savob/drone_computer/hardware/renders/flight_controller_v2_front.png

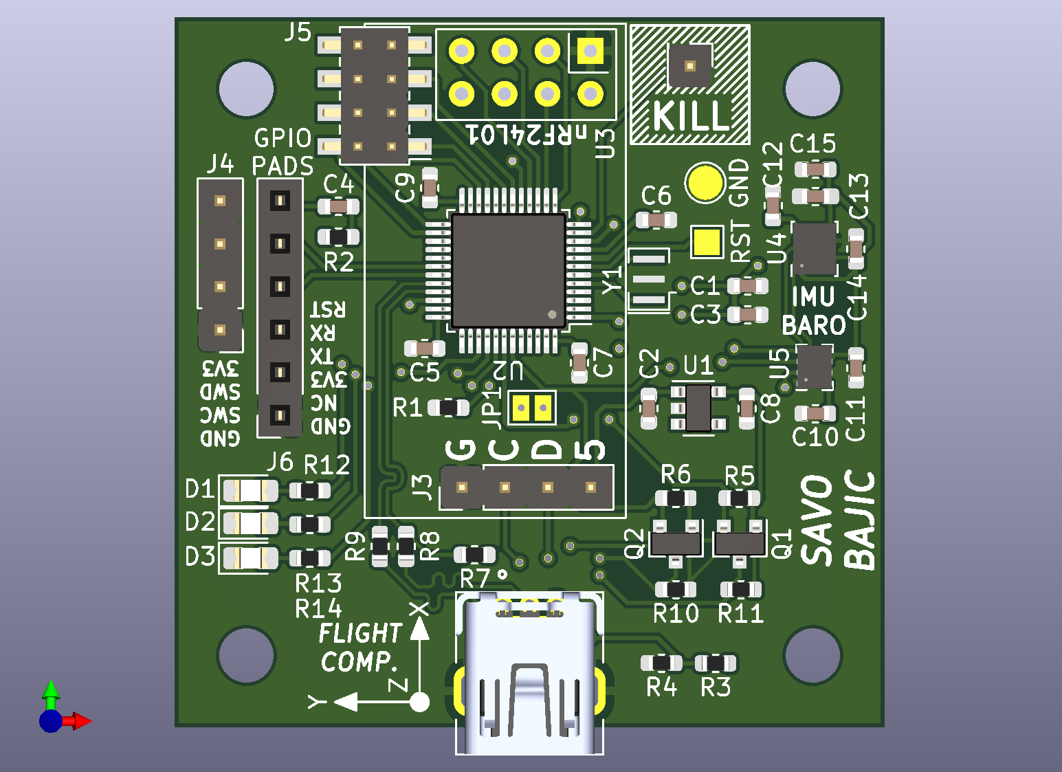
hardware/renders/flight_controller_v2_front.png
