savob/drone_computer/hardware/renders/flight_controller_v2_back.png

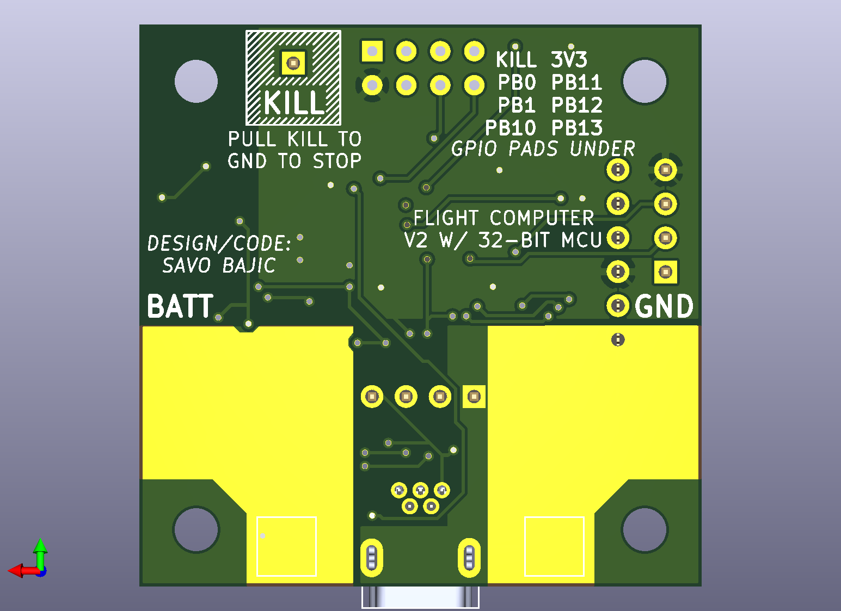
hardware/renders/flight_controller_v2_back.png
