savob/drone_computer/readme.md

# Flight Computer Project

This is the code and hardware design files for my custom flight computer board and its components.

It's been on a haitus for a while, I hope to pick it up again sometime though.
