savob/drone_computer/hardware/README.md

# Flight Computer Hardware Files

Here are the files related to the hardware design. They are all from KiCad 7.0.10 at the oldest.

## Projects

| Project | Description |
| --- | --- |
| `drone_regulator` | An noise rejecting voltage regulator board |
| `flight_computer_vX` | Different versions of the flight computer |

## Other Files and Folders

| Folder | Purpose |
| --- | --- |
| `renders` | Front and back 3D renders of the boards |
| `schematics` | Has the schematics in PDF (colour and B/W) and SVG (just colour) formats |
| `small_title_block.kicad_wks` | has the worksheet template with a more compact titleblock |
