savob/drone_computer/firmware/computer_v2/readme.md

# Flight Computer Code

This is the code for my custom flight computer board and its components.
