savob/drone_computer/hardware/renders/flight_controller_back.png

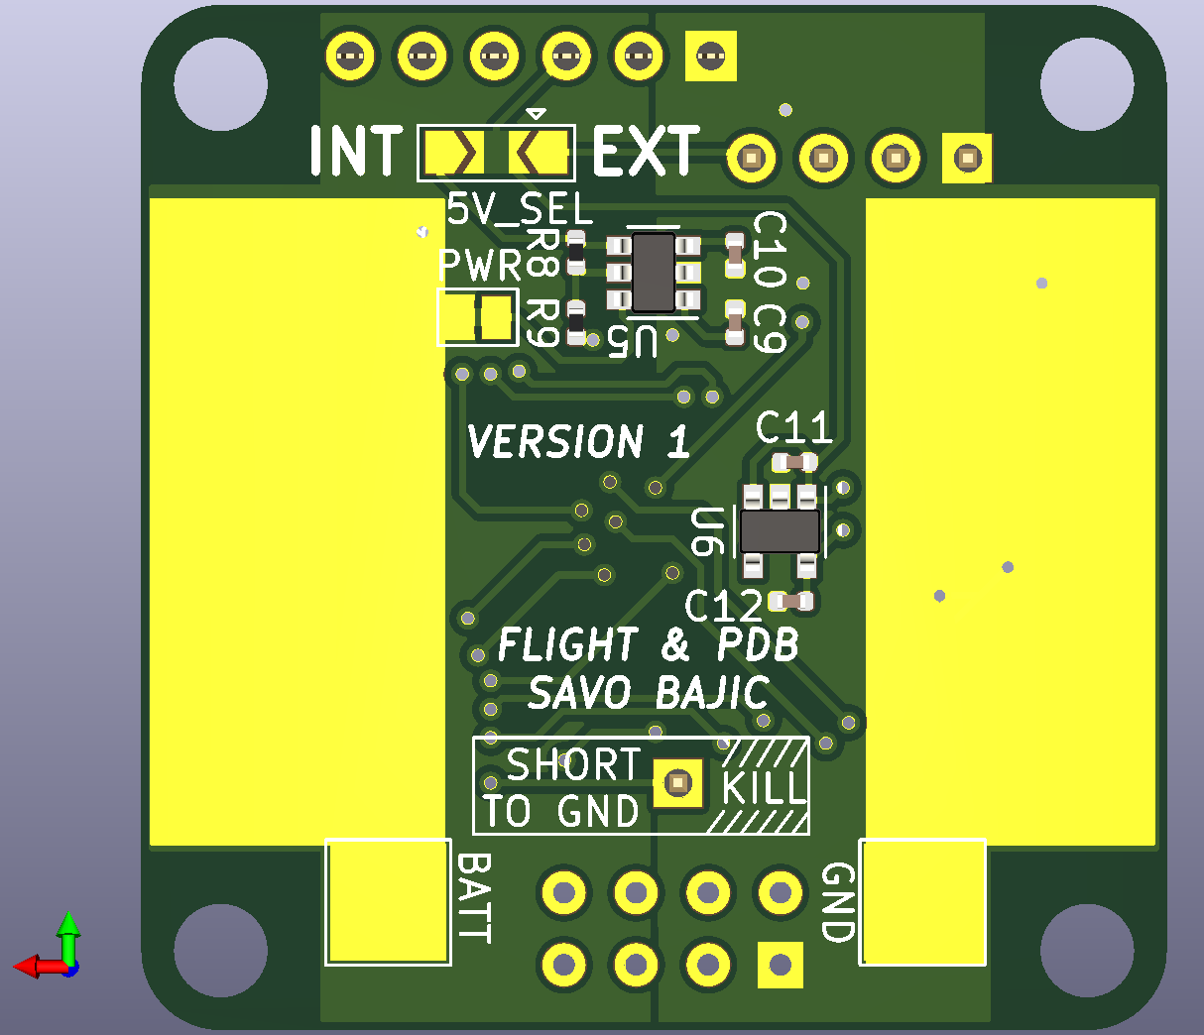
hardware/renders/flight_controller_back.png
