savob/drone_computer/hardware/renders/flight_controller_front.png

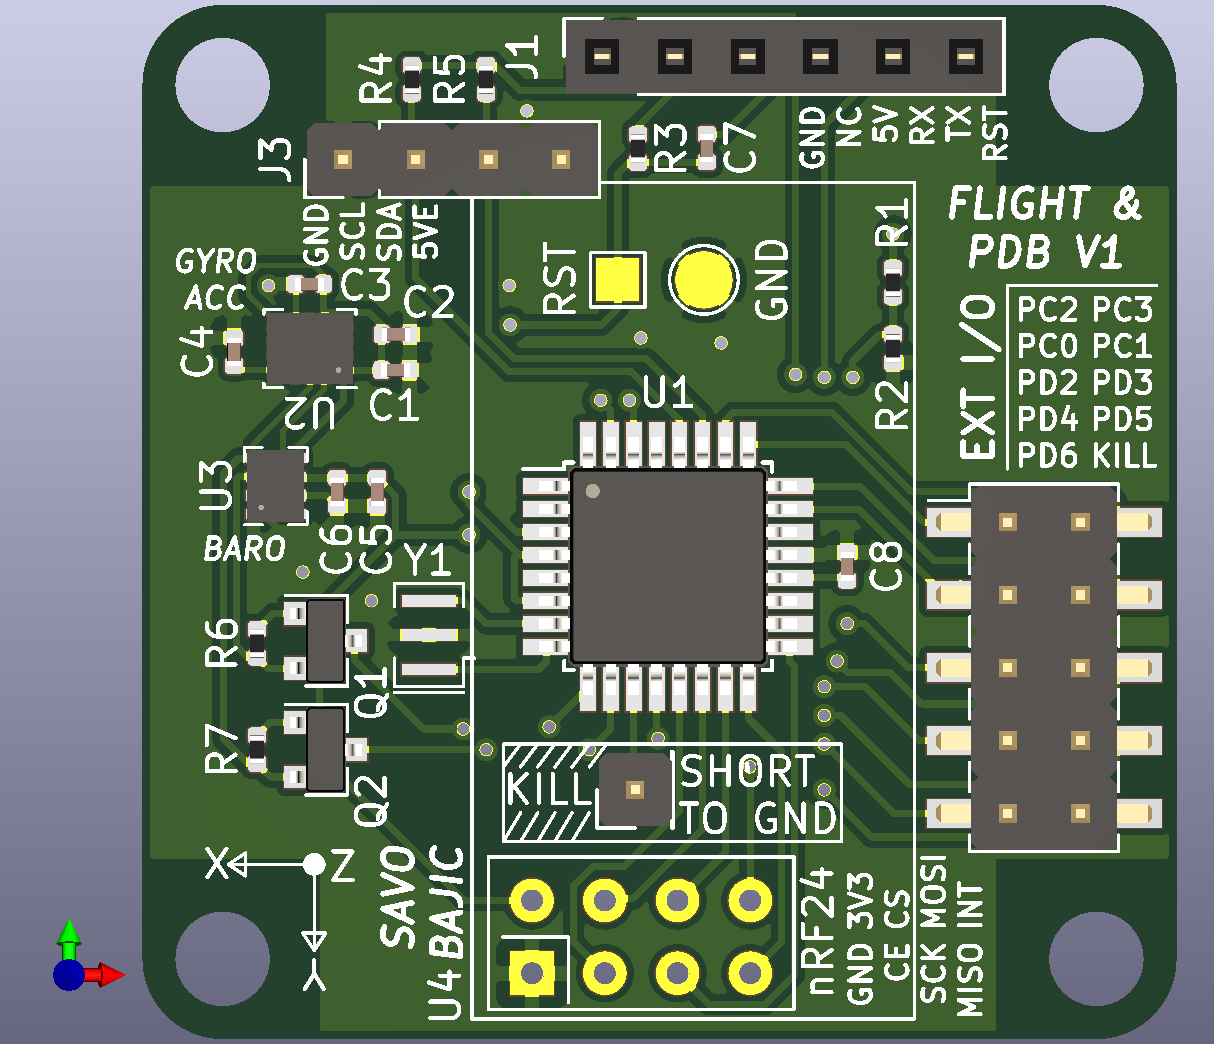
hardware/renders/flight_controller_front.png
