savob/drone_computer/hardware/flight_controller_v2/2172034-1/2172034-1--3DModel-STEP-56544.STEP

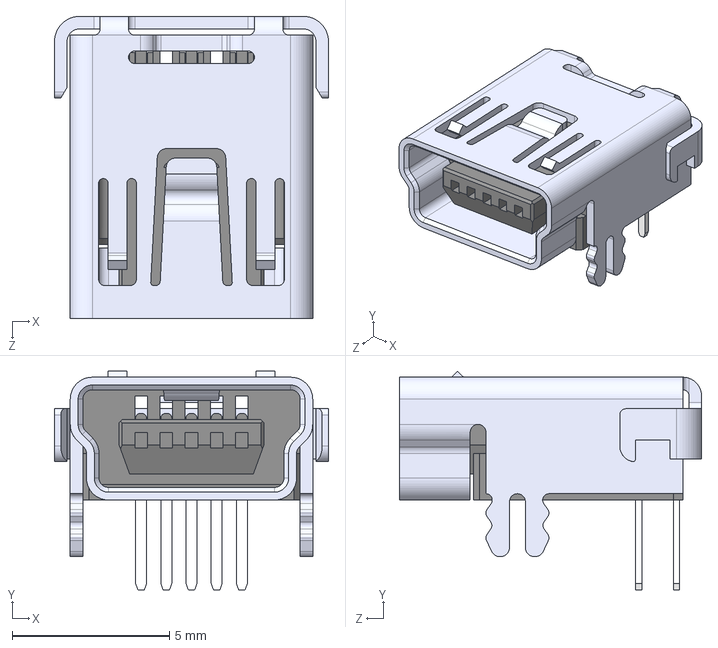
[picture p5: CAD file, 2024-01-08]
hardware/flight_controller_v2/2172034-1/2172034-1--3DModel-STEP-56544.STEP
8.70 x 6.94 x 9.60 mm
