savob/drone_computer/hardware/drone_regulator/drone_regulator.pdf

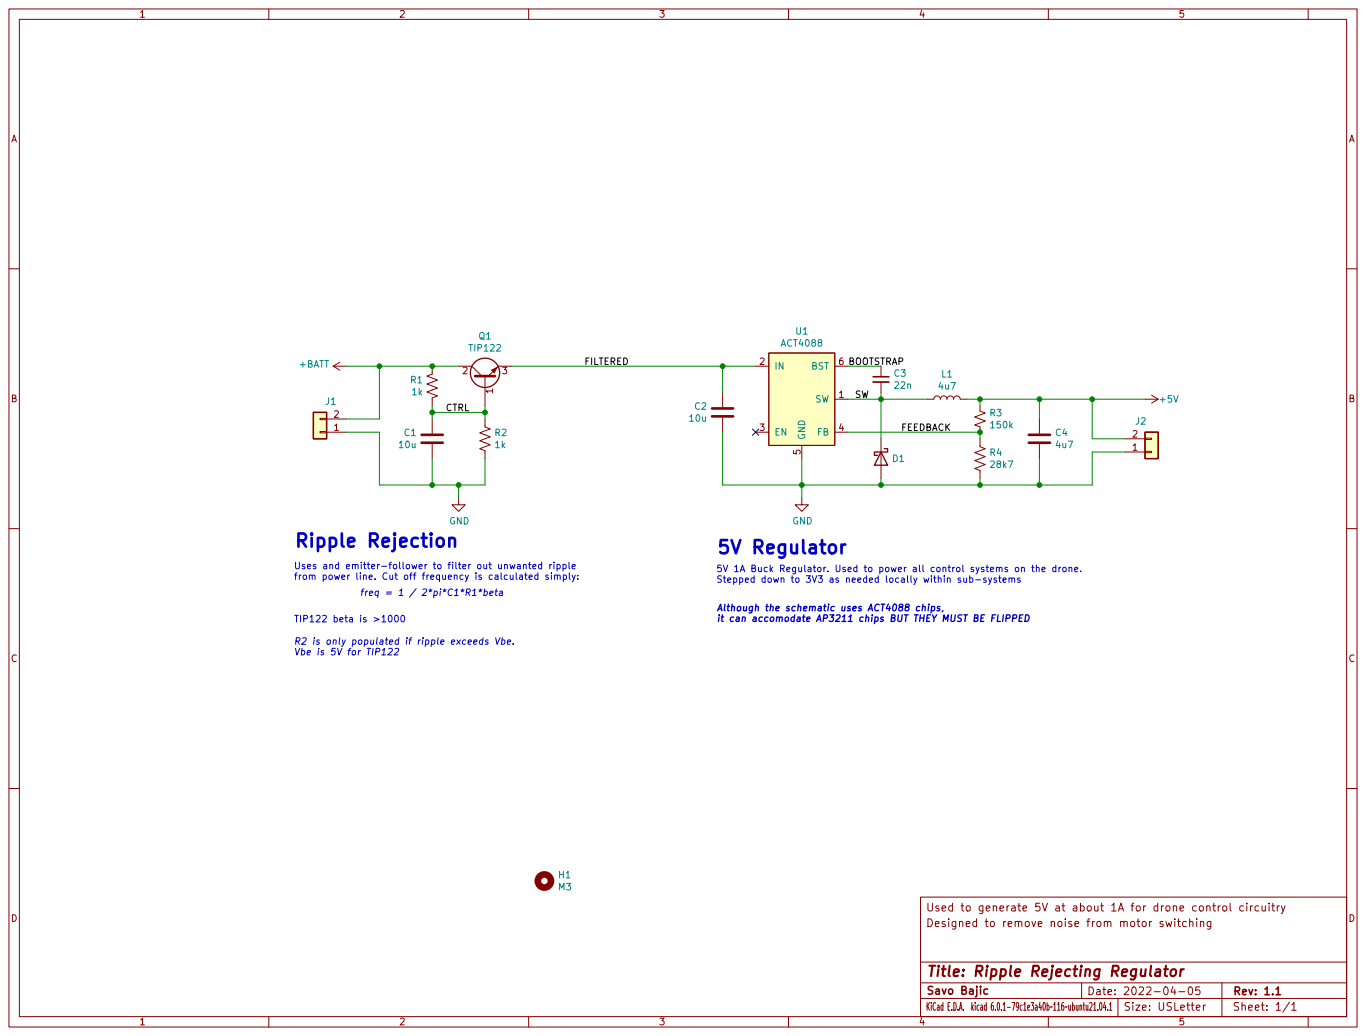
[picture p6: page 1]

Used to generate 5V at about 1A for drone control circuitry KiCad E.D.A. kicad 6.0.1-79c1e3a40b~116~ubuntu21.04.1 R3

Uses and emitter-follower to filter out unwanted ripple
from power line. Cut off frequency is calculated simply: TIP122 beta is >1000

5V 1A Buck Regulator. Used to power all control systems on the drone.
Stepped down to 3V3 as needed locally within sub-systems

it can accomodate AP3211 chips BUT THEY MUST BE FLIPPED

Designed to remove noise from motor switching
