savob/drone_computer/hardware/schematics/flight_controller_v2.pdf

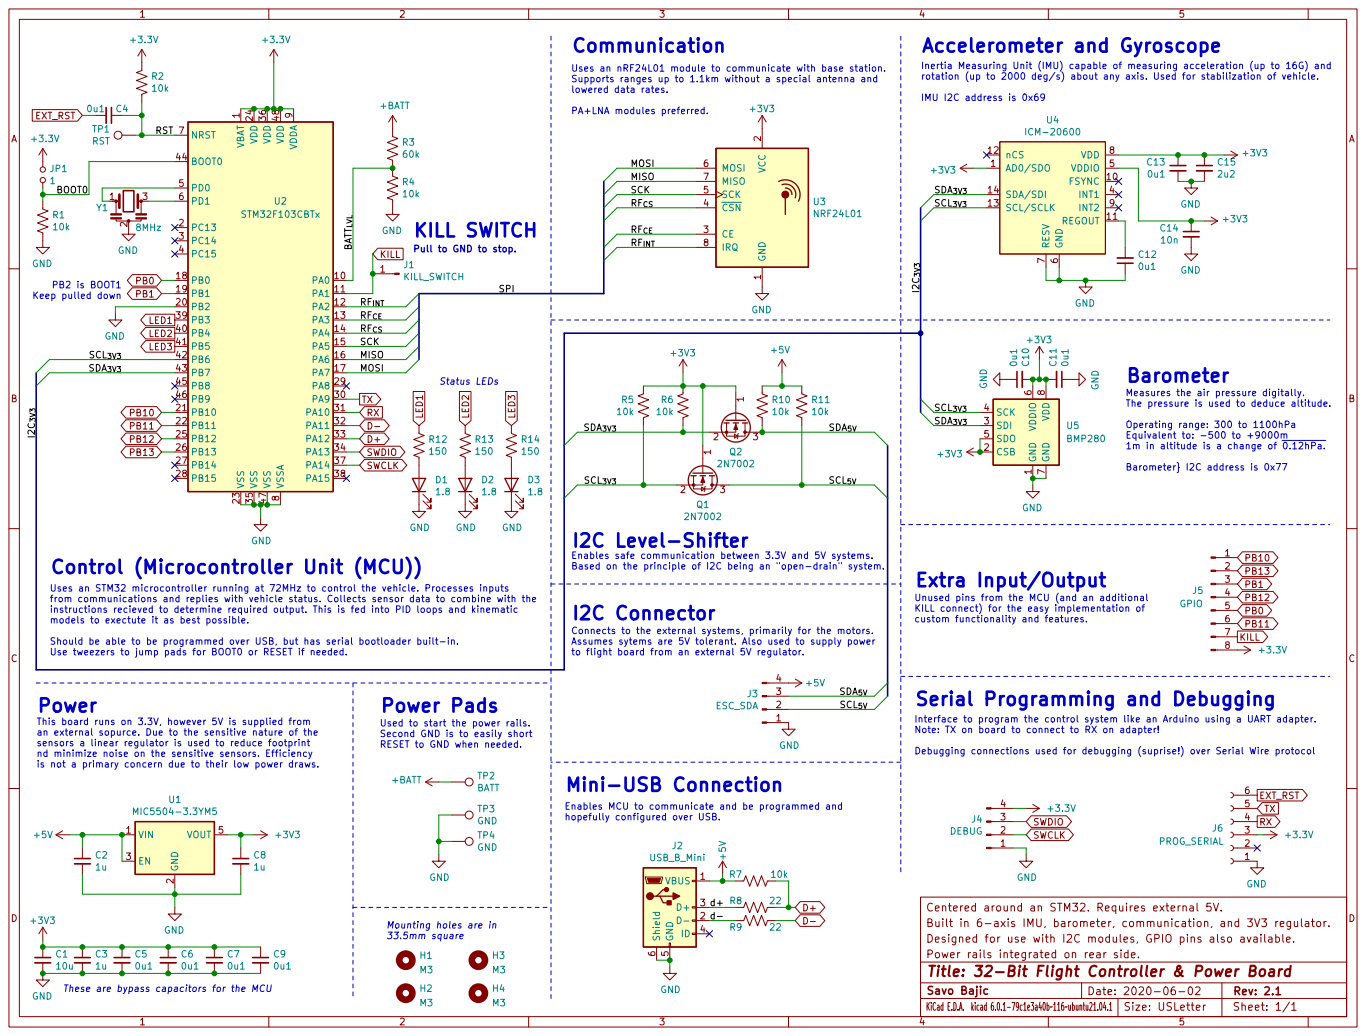
[picture p8: page 1]
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

IMU I2C address is 0x69 Used to start the power rails.

lowered data rates. PA+LNA modules preferred.

1 PA0 10 PA1 11 PA2 12 PA3 13 PA4 14 PA5 15 PA6 16 PA7 17 PB0 18 PB1 19 PC13 2 PB2 20 PB10 21 PB11 22 VSS 23 VDD 24 PB12 25 PB13 26 PB14 27 PB15 28 PA8 29 PC14 3 PA9 30 PA10 31 PA11 32 PA12 33 PA13 34 VSS 35 VDD 36 PA14 37 PA15 38 PB3 39 PC15 4 PB4 40 PB5 41 PB6 42 PB7 43 BOOT0 44 PB8 45 PB9 46 VSS 47 VDD 48 PD0 5 PD1 6 NRST 7 VSSA

2 CE 3 ~{CSN} 4 SCK 5 MOSI 6 MISO 7
RF_{INT} MISO

Status LEDs Pull to GND to stop.
J1KILL_SWITCH

PB2 is BOOT1 Keep pulled down

Measures the air pressure digitally.
The pressure is used to deduce altitude.

1 CSB 2 SDI 3 SCK 4 SDO 5 VDDIO

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

Control (Microcontroller Unit (MCU))

Second GND is to easily short RESET to GND when needed. Uses an STM32 microcontroller running at 72MHz to control the vehicle. Processes inputs
from communications and replies with vehicle status. Collects sensor data to combine with the
instructions recieved to determine required output. This is fed into PID loops and kinematic
models to exectute it as best possible.

Unused pins from the MCU (and an additional
KILL connect) for the easy implementation of
custom functionality and features.

Should be able to be programmed over USB, but has serial bootloader built-in.
Use tweezers to jump pads for BOOT0 or RESET if needed.

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

Serial Programming and Debugging

This board runs on 3.3V, however 5V is supplied from
an external sopurce. Due to the sensitive nature of the
sensors a linear regulator is used to reduce footprint
nd minimize noise on the sensitive sensors. Efficiency
is not a primary concern due to their low power draws.

Interface to program the control system like an Arduino using a UART adapter.
Note: TX on board to connect to RX on adapter!

Debugging connections used for debugging (suprise!) over Serial Wire protocol

Enables MCU to communicate and be programmed and
hopefully configured over USB.

Centered around an STM32. Requires external 5V. KiCad E.D.A. kicad 6.0.1-79c1e3a40b~116~ubuntu21.04.1 C2

Built in 6-axis IMU, barometer, communication, and 3V3 regulator.
Designed for use with I2C modules, GPIO pins also available.
Power rails integrated on rear side.

Mounting holes are in
33.5mm square

These are bypass capacitors for the MCU
