savob/drone_computer/hardware/drone_regulator/drone_regulator.kicad_pcb

## KiCad design hardware/drone_regulator/drone_regulator.kicad_pcb (2024-01-08)

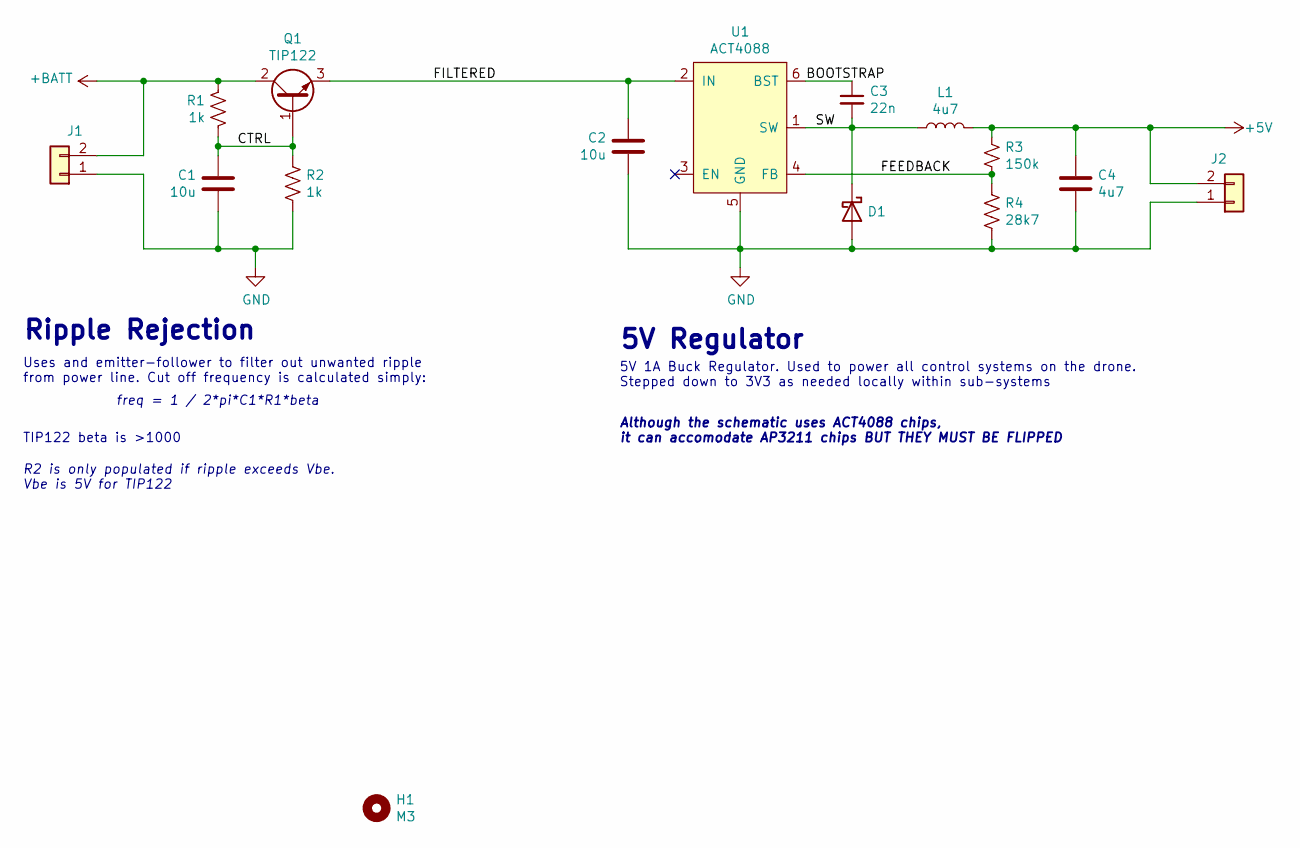
[picture p9: schematic drone_regulator.kicad_sch, Ripple Rejecting Regulator]

Parts:
C1: 10u; C_Radial_D6.3mm_H7.0mm_P2.50mm
C2: 10u; C_0805_2012Metric
C3: 22n; C_0402_1005Metric
C4: 4u7; C_0805_2012Metric
D1: 0v7; D_SOD-323
H1: M3; MountingHole_3.2mm_M3
J1, J2: Conn_01x02; PinHeader_1x02_P2.54mm_Vertical
L1: 4u7; L_Taiyo-Yuden_NR-30xx
Q1: TIP122; TO-220-3_Vertical
R1, R2: 1k; R_Axial_DIN0207_L6.3mm_D2.5mm_P2.54mm_Vertical
R3: 150k; R_0402_1005Metric
R4: 28k7; R_0402_1005Metric
U1: ACT4088; SOT-23-6

Connections:
+5V: C4.1, J2.2, L1.2, R3.1
+BATT: J1.2, Q1.2 (C), R1.2
/BOOTSTRAP: C3.1, U1.6 (BST)
/CTRL: C1.2, Q1.1 (B), R1.1, R2.2
/FEEDBACK: R3.2, R4.1, U1.4 (FB)
/FILTERED: C2.2, Q1.3 (E), U1.2 (IN)
/SW: C3.2, D1.1 (K), L1.1, U1.1 (SW)
GND: C1.1, C2.1, C4.2, D1.2 (A), J1.1, J2.1, R2.1, R4.2, U1.5 (GND)

Notes on the sheet:
5V 1A Buck Regulator. Used to power all control systems on the drone. Stepped down to 3V3 as needed locally within sub-systems
R2 is only populated if ripple exceeds Vbe. Vbe is 5V for TIP122
Ripple Rejection
Although the schematic uses ACT4088 chips, it can accomodate AP3211 chips BUT THEY MUST BE FLIPPED
Uses and emitter-follower to filter out unwanted ripple from power line. Cut off frequency is calculated simply: TIP122 beta is >1000
5V Regulator
freq = 1 / 2*pi*C1*R1*beta

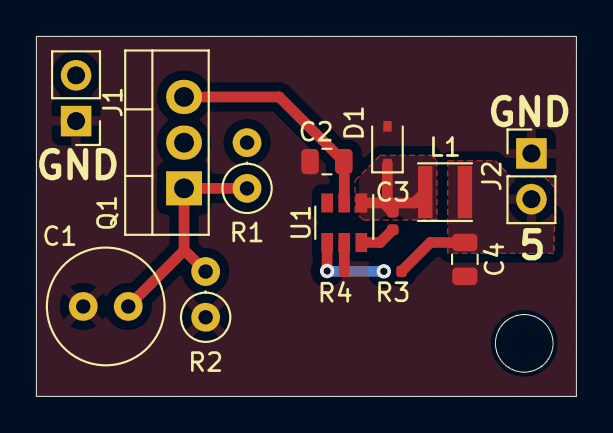
[picture p10: board drone_regulator.kicad_pcb from above]

Board: 2 copper layers, 30.0 x 20.0 mm, 15 parts (0 on the bottom side), 8 nets.
