savob/drone_computer/hardware/flight_controller_v2/flight_controller_v2.kicad_pcb

## KiCad design hardware/flight_controller_v2/flight_controller_v2.kicad_pcb (2024-01-08)

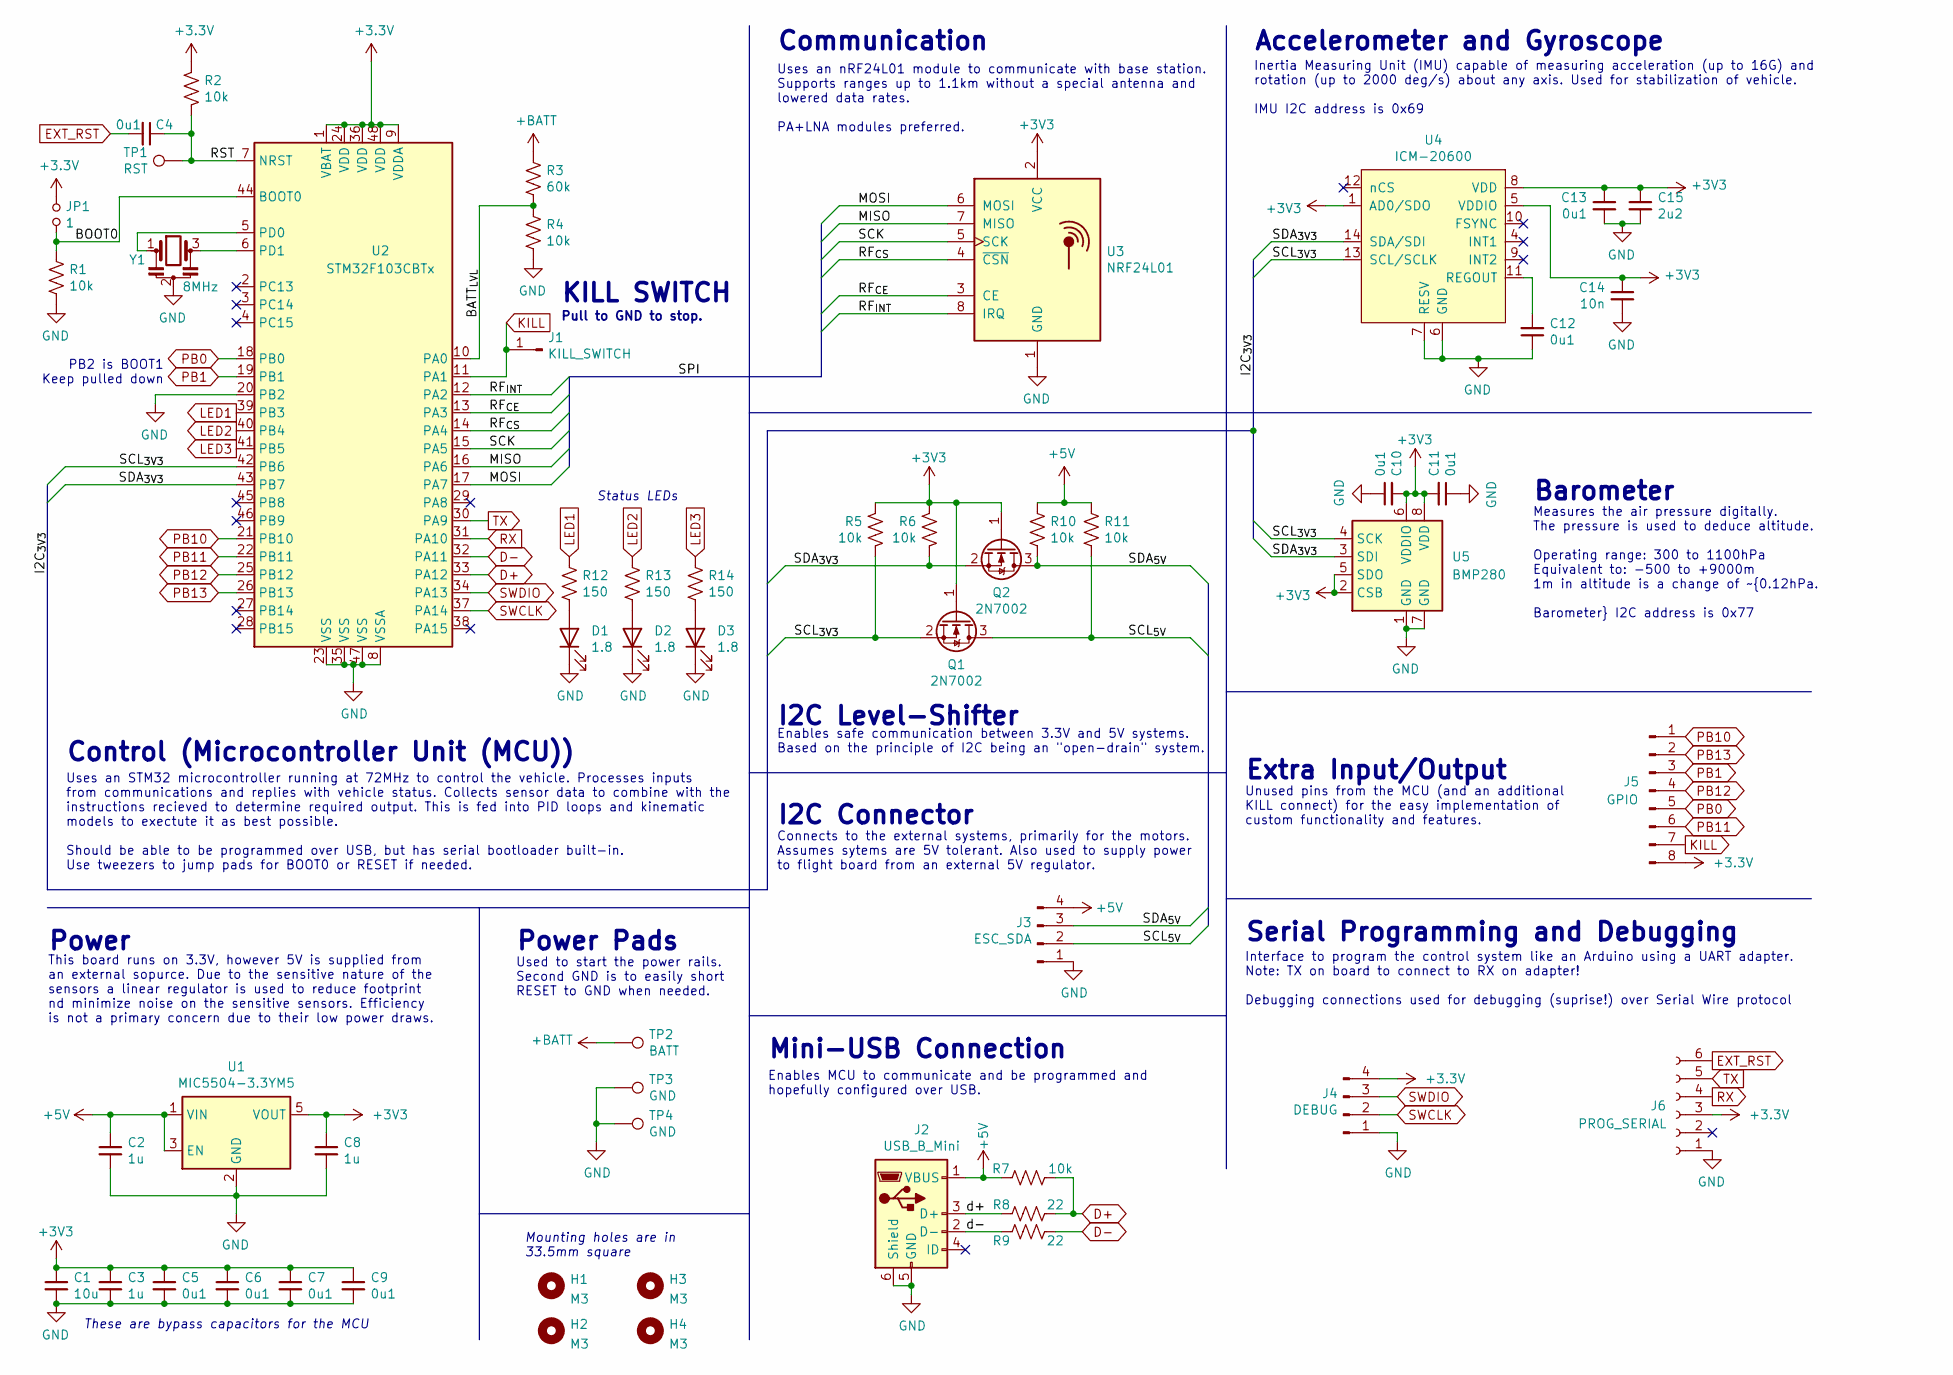
[picture p11: schematic flight_controller_v2.kicad_sch, 32-Bit Flight Controller & Power Board]

Parts:
C1: 10u; C_0603_1608Metric
C2, C3, C8: 1u; C_0603_1608Metric
C4, C5, C6, C7, C9, C10, C11, C12, C13: 0u1; C_0603_1608Metric
C14: 10n; C_0603_1608Metric
C15: 2u2; C_0603_1608Metric
D1, D2, D3: 1.8; LED_0805_2012Metric_Castellated
H1, H2, H3, H4: M3; MountingHole_3.2mm_M3
J1: KILL_SWITCH; PinHeader_1x01_P2.54mm_Vertical
J2: USB_B_Mini; TE_2172034-1
J3: ESC_SDA; PinHeader_1x04_P2.54mm_Vertical
J4: DEBUG; PinHeader_1x04_P2.54mm_Vertical
J5: GPIO; PinHeader_2x04_P2.00mm_Vertical_SMD
J6: PROG_SERIAL; PinSocket_1x06_P2.54mm_Vertical
JP1: 1; SolderJumper-2_P1.3mm_Open_Pad1.0x1.5mm
Q1, Q2: 2N7002; SOT-23
R1, R2, R4, R5, R6, R7, R10, R11: 10k; R_0603_1608Metric
R3: 60k; R_0603_1608Metric
R8, R9: 22; R_0603_1608Metric
R12, R13, R14: 150; R_0603_1608Metric
TP1: RST; TestPoint_Pad_1.5x1.5mm
TP2: BATT; TestPoint_Pad_4.0x4.0mm
TP3: GND; TestPoint_Pad_D2.0mm
TP4: GND; TestPoint_Pad_4.0x4.0mm
U1: MIC5504-3.3YM5; SOT-23-5
U2: STM32F103CBTx; LQFP-48_7x7mm_P0.5mm
U3: NRF24L01; nRF24L01_Breakout
U4: ICM-20600; LGA-14_3x2.5mm_P0.5mm_LayoutBorder3x4y
U5: BMP280; Bosch_LGA-8_2x2.5mm_P0.65mm_ClockwisePinNumbering
Y1: 8MHz; Resonator_SMD_muRata_CSTxExxV-3Pin_3.0x1.1mm

Connections:
+5V: C2.1, J2.1 (VBUS), J3.4, R7.1, R10.1, R11.1, U1.1 (VIN), U1.3 (EN)
+BATT: R3.1, TP2.1
/BATT_{LVL}: R3.2, R4.1, U2.10 (PA0)
/BOOT0: JP1.1, R1.1, U2.44 (BOOT0)
/MISO: U2.16 (PA6), U3.7 (MISO)
/MOSI: U2.17 (PA7), U3.6 (MOSI)
/RF_{CE}: U2.13 (PA3), U3.3 (CE)
/RF_{CS}: U2.14 (PA4), U3.4 (~CSN)
/RF_{INT}: U2.12 (PA2), U3.8 (IRQ)
/RST: C4.1, R2.2, TP1.1, U2.7 (NRST)
/SCK: U2.15 (PA5), U3.5 (SCK)
/SCL_{3V3}: Q1.2 (S), R5.2, U2.42 (PB6), U4.13 (SCL/SCLK), U5.4 (SCK)
/SCL_{5V}: J3.2, Q1.3 (D), R11.2
/SDA_{3V3}: Q2.2 (S), R6.2, U2.43 (PB7), U4.14 (SDA/SDI), U5.3 (SDI)
/SDA_{5V}: J3.3, Q2.3 (D), R10.2
/d+: J2.3 (D+), R8.2
/d-: J2.2 (D-), R9.1
D+: R7.2, R8.1, U2.33 (PA12)
D-: R9.2, U2.32 (PA11)
EXT_RST: C4.2, J6.6
GND: C1.2, C2.2, C3.2, C5.2, C6.2, C7.2, C8.2, C9.2, C10.1, C11.1, C12.1, C13.2, C14.2, C15.2, D1.1 (K), D2.1 (K), D3.1 (K), J2.5 (GND), J2.6 (Shield), J3.1, J4.1, J6.1, R1.2, R4.2, TP3.1, TP4.1, U1.2 (GND), U2.8 (VSSA), U2.20 (PB2), U2.23 (VSS), U2.35 (VSS), U2.47 (VSS), U3.1 (GND), U4.6 (GND), U4.7 (RESV), U5.1 (GND), U5.7 (GND), Y1.2
KILL: J1.1, J5.7, U2.11 (PA1)
LED1: R12.1, U2.39 (PB3)
LED2: R13.1, U2.40 (PB4)
LED3: R14.1, U2.41 (PB5)
unnamed: C12.2, U4.11 (REGOUT)
unnamed: D1.2 (A), R12.2
unnamed: D2.2 (A), R13.2
unnamed: D3.2 (A), R14.2
unnamed: U2.5 (PD0), Y1.1
unnamed: U2.6 (PD1), Y1.3
PB0: J5.5, U2.18 (PB0)
PB1: J5.3, U2.19 (PB1)
PB10: J5.1, U2.21 (PB10)
PB11: J5.6, U2.22 (PB11)
PB12: J5.4, U2.25 (PB12)
PB13: J5.2, U2.26 (PB13)
RX: J6.4, U2.31 (PA10)
SWCLK: J4.2, U2.37 (PA14)
SWDIO: J4.3, U2.34 (PA13)
TX: J6.5, U2.30 (PA9)

Notes on the sheet:
Accelerometer and Gyroscope
This board runs on 3.3V, however 5V is supplied from an external sopurce. Due to the sensitive nature of the sensors a linear regulator is used to reduce footprint nd minimize noise on the sensitive sensors. Efficiency is not a primary concern due to their low power draws.
Barometer
Power
Extra Input/Output
I2C Level-Shifter
Enables safe communication between 3.3V and 5V systems. Based on the principle of I2C being an "open-drain" system.
I2C Connector
Pull to GND to stop.
Interface to program the control system like an Arduino using a UART adapter. Note: TX on board to connect to RX on adapter! Debugging connections used for debugging (suprise!) over Serial Wire protocol
Status LEDs
Used to start the power rails. Second GND is to easily short RESET to GND when needed.
Uses an nRF24L01 module to communicate with base station. Supports ranges up to 1.1km without a special antenna and lowered data rates. PA+LNA modules preferred.
Mounting holes are in 33.5mm square
Power Pads
Control (Microcontroller Unit (MCU))
Serial Programming and Debugging
PB2 is BOOT1 Keep pulled down
Inertia Measuring Unit (IMU) capable of measuring acceleration (up to 16G) and rotation (up to 2000 deg/s) about any axis. Used for stabilization of vehicle. IMU I2C address is 0x69
Mini-USB Connection
Communication
KILL SWITCH
Uses an STM32 microcontroller running at 72MHz to control the vehicle. Processes inputs from communications and replies with vehicle status. Collects sensor data to combine with the instructions recieved to determine required output. This is fed into PID loops and kinematic models to exectute it as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
Enables MCU to communicate and be programmed and hopefully configured over USB.
Connects to the external systems, primarily for the motors. Assumes sytems are 5V tolerant. Also used to supply power to flight board from an external 5V regulator.
These are bypass capacitors for the MCU
Unused pins from the MCU (and an additional KILL connect) for the easy implementation of custom functionality and features.
Measures the air pressure digitally. The pressure is used to deduce altitude. Operating range: 300 to 1100hPa Equivalent to: -500 to +9000m 1m in altitude is a change of ~{0.12hPa. Barometer} I2C address is 0x77

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
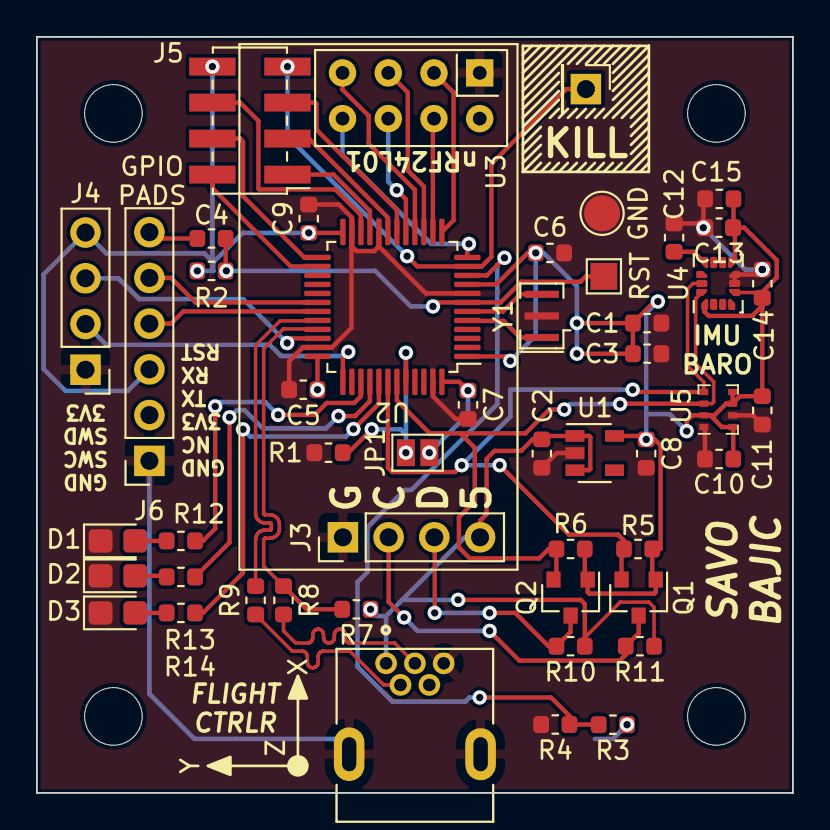
[picture p12: board flight_controller_v2.kicad_pcb from above]

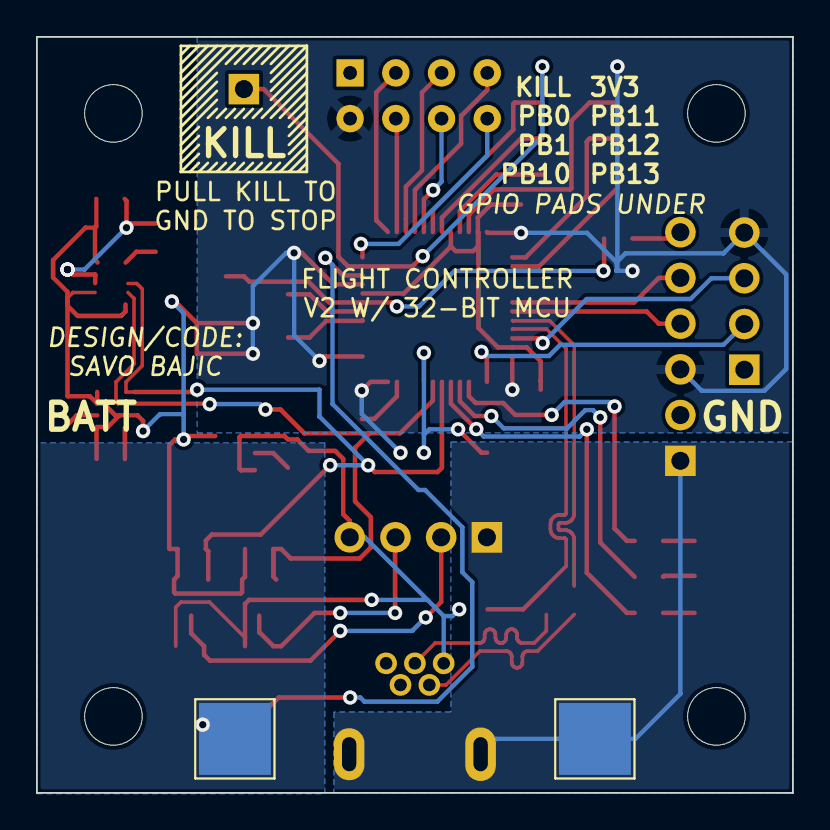
[picture p13: board flight_controller_v2.kicad_pcb from below]

Board: 2 copper layers, 42.0 x 42.0 mm, 55 parts (2 on the bottom side), 42 nets.
