savob/drone_computer/hardware/flight_controller/flight_controller.kicad_pcb

## KiCad design hardware/flight_controller/flight_controller.kicad_pcb (2024-01-08)

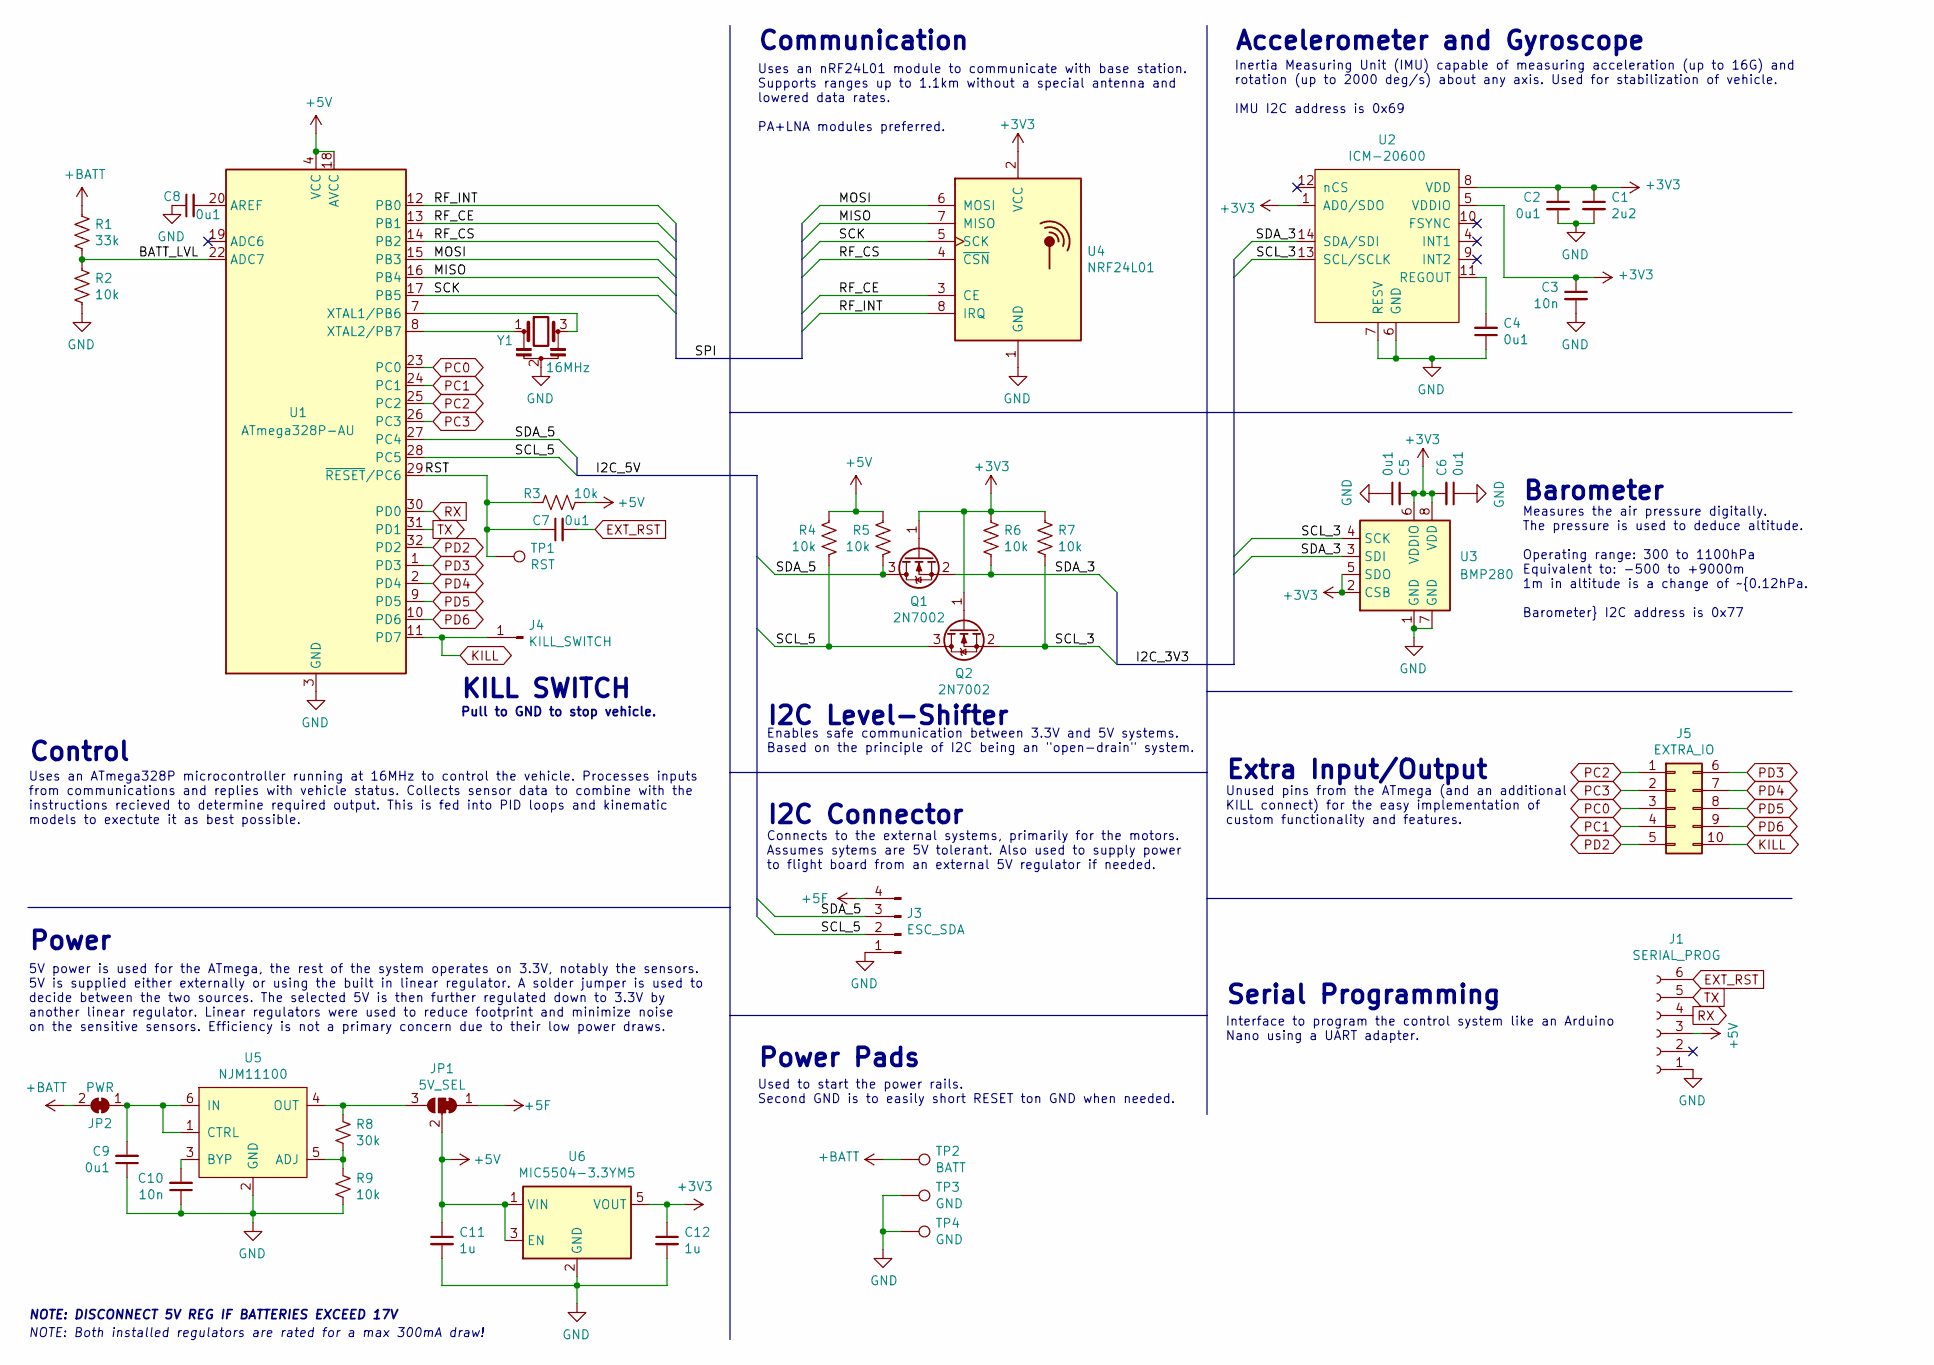
[picture p14: schematic flight_controller.kicad_sch, Flight Controller & Power Distribution Board]

Parts:
C1: 2u2; C_0402_1005Metric
C2, C4, C5, C6, C7, C8, C9: 0u1; C_0402_1005Metric
C3, C10: 10n; C_0402_1005Metric
C11, C12: 1u; C_0402_1005Metric
J1: SERIAL_PROG; PinSocket_1x06_P2.54mm_Vertical
J3: ESC_SDA; PinHeader_1x04_P2.54mm_Vertical
J4: KILL_SWITCH; PinHeader_1x01_P2.54mm_Vertical
J5: EXTRA_IO; PinHeader_2x05_P2.54mm_Vertical_SMD
JP1: 5V_SEL; SolderJumper-3_P2.0mm_Open_TrianglePad1.0x1.5mm
JP2: PWR; SolderJumper-2_P1.3mm_Bridged_Pad1.0x1.5mm
Q1, Q2: 2N7002; SOT-23
R1: 33k; R_0402_1005Metric
R2, R3, R4, R5, R6, R7, R9: 10k; R_0402_1005Metric
R8: 30k; R_0402_1005Metric
TP1: RST; TestPoint_Pad_1.5x1.5mm
TP2: BATT; TestPoint_Pad_4.0x4.0mm
TP3: GND; TestPoint_Pad_D2.0mm
TP4: GND; TestPoint_Pad_4.0x4.0mm
U1: ATmega328P-AU; TQFP-32_7x7mm_P0.8mm
U2: ICM-20600; LGA-14_3x2.5mm_P0.5mm_LayoutBorder3x4y
U3: BMP280; Bosch_LGA-8_2x2.5mm_P0.65mm_ClockwisePinNumbering
U4: NRF24L01; nRF24L01_Breakout
U5: NJM11100; SOT-23-6
U6: MIC5504-3.3YM5; SOT-23-5
Y1: 16MHz; Resonator_SMD_muRata_CSTxExxV-3Pin_3.0x1.1mm

Connections:
+3V3: C1.1, C2.1, C3.1, C5.2, C6.2, C12.1, Q1.1 (G), Q2.1 (G), R6.1, R7.1, U2.1 (AD0/SDO), U2.5 (VDDIO), U2.8 (VDD), U3.2 (CSB), U3.5 (SDO), U3.6 (VDDIO), U3.8 (VDD), U4.2 (VCC), U6.5 (VOUT)
+5F: J3.4, JP1.1 (A)
+5V: C11.1, J1.3, JP1.2 (C), R3.1, R4.1, R5.1, U1.4 (VCC), U1.6 (VCC), U1.18 (AVCC), U6.1 (VIN), U6.3 (EN)
+BATT: JP2.2 (B), R1.1, TP2.1
/BATT_LVL: R1.2, R2.1, U1.22 (ADC7)
/MISO: U1.16 (PB4), U4.7 (MISO)
/MOSI: U1.15 (PB3), U4.6 (MOSI)
/RF_CE: U1.13 (PB1), U4.3 (CE)
/RF_CS: U1.14 (PB2), U4.4 (~CSN)
/RF_INT: U1.12 (PB0), U4.8 (IRQ)
/RST: C7.1, R3.2, TP1.1, U1.29 (~RESET/PC6)
/SCK: U1.17 (PB5), U4.5 (SCK)
/SCL_3: Q2.2 (S), R7.2, U2.13 (SCL/SCLK), U3.4 (SCK)
/SCL_5: J3.2, Q2.3 (D), R4.2, U1.28 (PC5)
/SDA_3: Q1.2 (S), R6.2, U2.14 (SDA/SDI), U3.3 (SDI)
/SDA_5: J3.3, Q1.3 (D), R5.2, U1.27 (PC4)
EXT_RST: C7.2, J1.6
GND: C1.2, C2.2, C3.2, C4.1, C5.1, C6.1, C8.1, C9.1, C10.1, C11.2, C12.2, J1.1, J3.1, R2.2, R9.2, TP3.1, TP4.1, U1.3 (GND), U1.5 (GND), U1.21 (GND), U2.6 (GND), U2.7 (RESV), U3.1 (GND), U3.7 (GND), U4.1 (GND), U5.2 (GND), U6.2 (GND), Y1.2
KILL: J4.1, J5.10, U1.11 (PD7)
unnamed: C4.2, U2.11 (REGOUT)
unnamed: C8.2, U1.20 (AREF)
unnamed: C9.2, JP2.1 (A), U5.1 (CTRL), U5.6 (IN)
unnamed: C10.2, U5.3 (BYP)
unnamed: JP1.3 (B), R8.1, U5.4 (OUT)
unnamed: R8.2, R9.1, U5.5 (ADJ)
unnamed: U1.7 (XTAL1/PB6), Y1.3
unnamed: U1.8 (XTAL2/PB7), Y1.1
PC0: J5.3, U1.23 (PC0)
PC1: J5.4, U1.24 (PC1)
PC2: J5.1, U1.25 (PC2)
PC3: J5.2, U1.26 (PC3)
PD2: J5.5, U1.32 (PD2)
PD3: J5.6, U1.1 (PD3)
PD4: J5.7, U1.2 (PD4)
PD5: J5.8, U1.9 (PD5)
PD6: J5.9, U1.10 (PD6)
RX: J1.4, U1.30 (PD0)
TX: J1.5, U1.31 (PD1)

Notes on the sheet:
I2C Connector
Connects to the external systems, primarily for the motors. Assumes sytems are 5V tolerant. Also used to supply power to flight board from an external 5V regulator if needed.
Power
KILL SWITCH
Inertia Measuring Unit (IMU) capable of measuring acceleration (up to 16G) and rotation (up to 2000 deg/s) about any axis. Used for stabilization of vehicle. IMU I2C address is 0x69
Enables safe communication between 3.3V and 5V systems. Based on the principle of I2C being an "open-drain" system.
Extra Input/Output
Measures the air pressure digitally. The pressure is used to deduce altitude. Operating range: 300 to 1100hPa Equivalent to: -500 to +9000m 1m in altitude is a change of ~{0.12hPa. Barometer} I2C address is 0x77
Control
Interface to program the control system like an Arduino Nano using a UART adapter.
Serial Programming
Unused pins from the ATmega (and an additional KILL connect) for the easy implementation of custom functionality and features.
Communication
5V power is used for the ATmega, the rest of the system operates on 3.3V, notably the sensors. 5V is supplied either externally or using the built in linear regulator. A solder jumper is used to decide between the two sources. The selected 5V is then further regulated down to 3.3V by another linear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
Power Pads
NOTE: Both installed regulators are rated for a max 300mA draw!
Uses an ATmega328P microcontroller running at 16MHz to control the vehicle. Processes inputs from communications and replies with vehicle status. Collects sensor data to combine with the instructions recieved to determine required output. This is fed into PID loops and kinematic models to exectute 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
Uses an nRF24L01 module to communicate with base station. Supports ranges up to 1.1km without a special antenna and lowered data rates. PA+LNA modules preferred.
Accelerometer and Gyroscope
I2C Level-Shifter
NOTE: DISCONNECT 5V REG IF BATTERIES EXCEED 17V
Pull to GND to stop vehicle.
Used to start the power rails. Second GND is to easily short RESET ton GND when needed.
Barometer

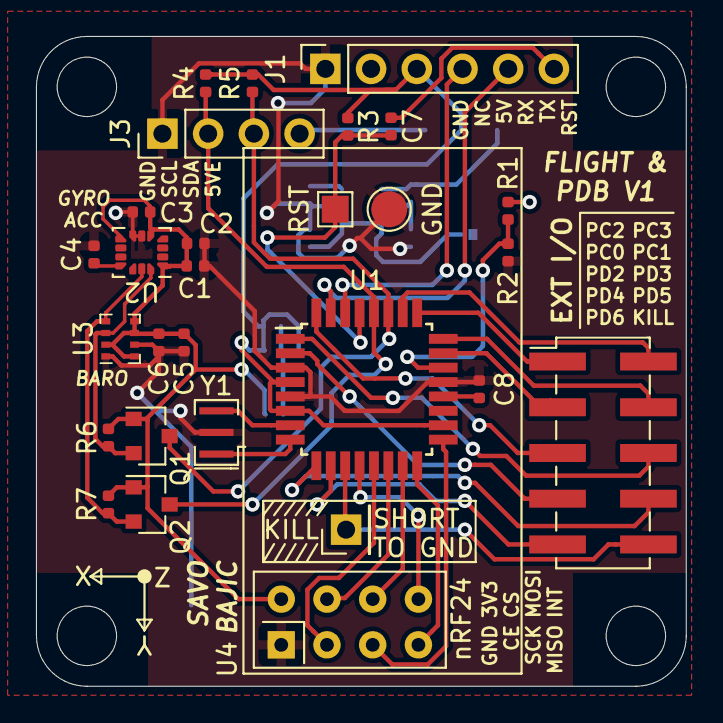
[picture p15: board flight_controller.kicad_pcb from above]

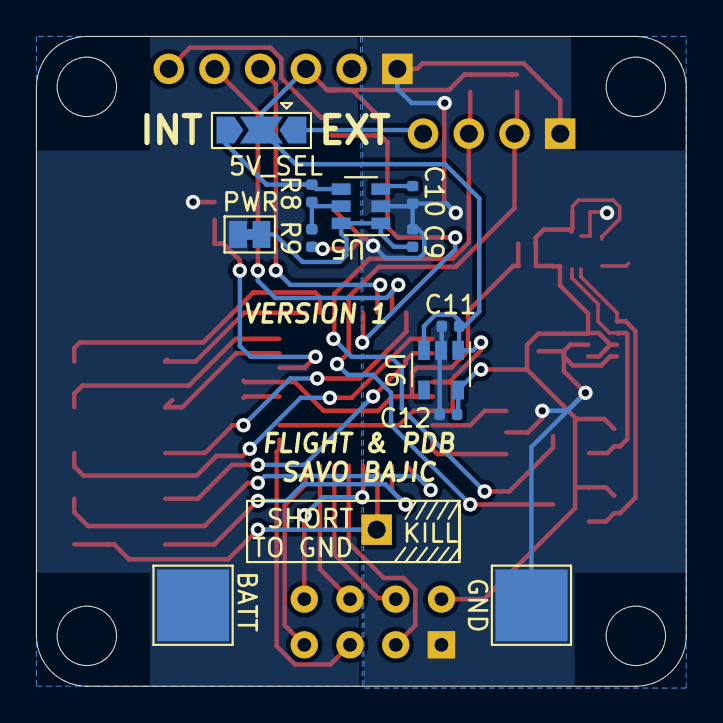
[picture p16: board flight_controller.kicad_pcb from below]

Board: 2 copper layers, 36.1 x 36.1 mm, 40 parts (12 on the bottom side), 38 nets.
