savob/drone_computer/(commit log)

2024-01-08 Upload of hardware files
    [2172034-1--3DModel-STEP-56544.STEP, flight_controller.kicad_pcb, flight_controller.kicad_sch, flight_controller_v2.kicad_pcb, flight_controller_v2.kicad_sch]
2024-01-08 Added regulator board
    [drone_regulator.kicad_pcb, drone_regulator.kicad_sch]
